hhtronik/qok-i-learn-soldering-th/schematic.pdf

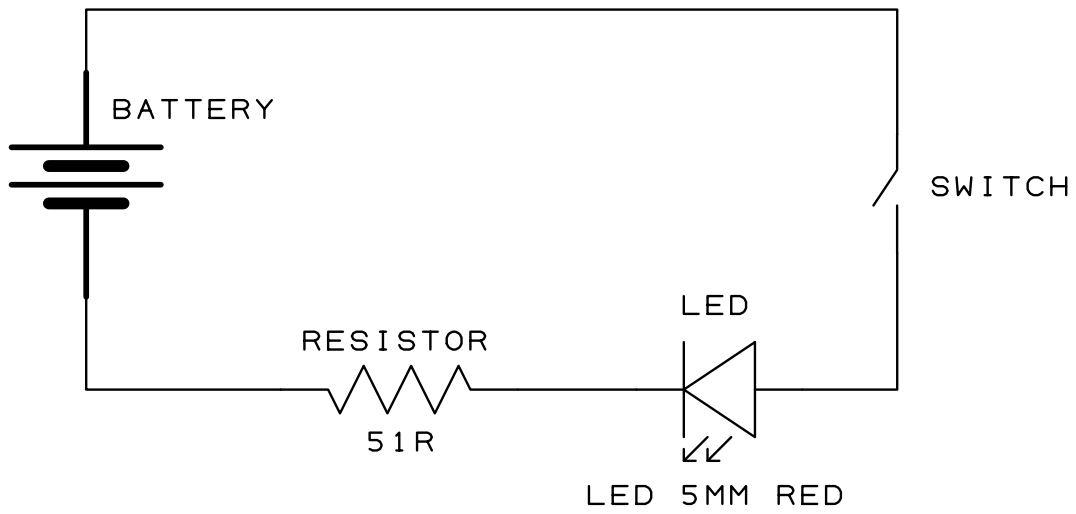
[picture p4: page 1]
