hhtronik/qok-i-learn-soldering-th/(list of files, drawings)

Other design files:
designspark/hhtqok-ils.pcb
