hhtronik/qok-i-learn-soldering-th/(commit log)

2020-04-06 Fixed switch footprint
    [hhtqok-ils.pcb, hhtqok-ils.sch]
2020-04-22 Updated pcb renderings and added a soldering 101 assembly guide
